the2fye/16v-boost-converter/hardware/boost_converter.kicad_pcb

## KiCad design hardware/boost_converter.kicad_pcb (2026-11-09)

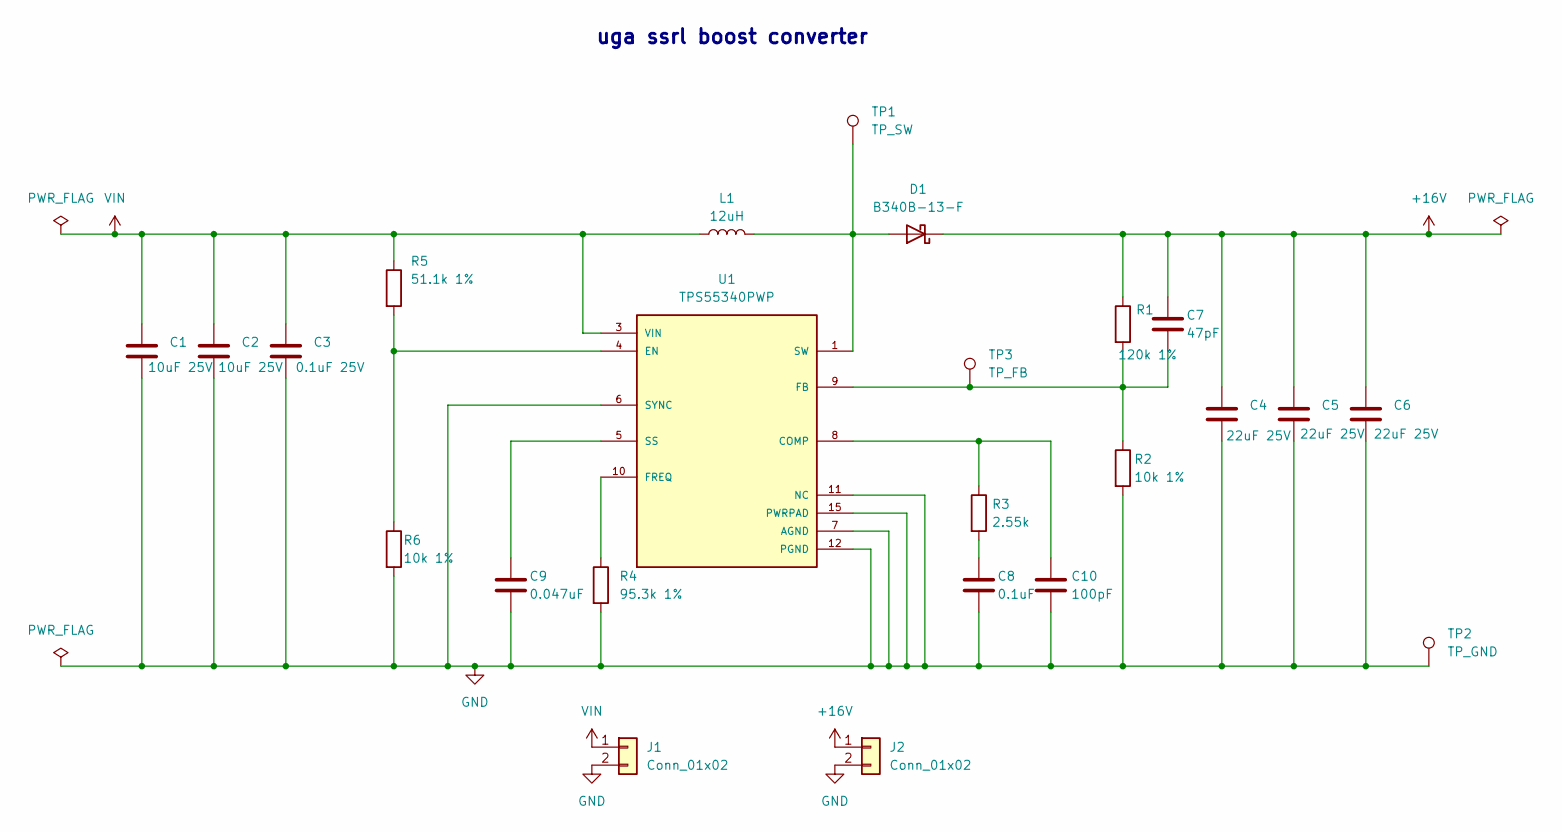
[picture p5: schematic boost_converter.kicad_sch]

Parts:
C1, C2: 10uF 25V; C_0805_2012Metric; MPN Murata GRM21BR61E106KA73L
C3: 0.1uF 25V; C_0603_1608Metric; MPN Murata GRM188R71E104KA01D
C4, C5, C6: 22uF 25V; C_1210_3225Metric; MPN Murata GRM32ER71E226KE15L
C7: 47pF; C_0603_1608Metric; MPN Murata GRM1885C1H470JA01D
C8: 0.1uF; C_0603_1608Metric; MPN Murata GRM188R71H104KA93D
C9: 0.047uF; C_0603_1608Metric; MPN Murata GRM188R71H473KA61D
C10: 100pF; C_0603_1608Metric; MPN Murata GRM1885C1H101JA01D
D1: B340B-13-F; D_SMB; MPN Diodes Inc. B340B-13-F
J1, J2: Conn_01x02; PinHeader_1x02_P2.54mm_Vertical; MPN Würth 61300211121
L1: 12uH; 744393465120; MPN Würth 744393465120
R1: 120k 1%; R_0603_1608Metric; MPN Yageo RC0603FR-07120KL
R2, R6: 10k 1%; R_0603_1608Metric; MPN Yageo RC0603FR-0710KL
R3: 2.55k; R_0603_1608Metric; MPN Yageo RC0603FR-072K55L
R4: 95.3k 1%; R_0603_1608Metric; MPN Yageo RC0603FR-0795K3L
R5: 51.1k 1%; R_0603_1608Metric; MPN Yageo RC0603FR-0751K1L
TP1: TP_SW; TestPoint_Pad_1.5x1.5mm
TP2: TP_GND; TestPoint_Pad_1.5x1.5mm
TP3: TP_FB; TestPoint_Pad_1.5x1.5mm
U1: TPS55340PWP; IC_TPS55340PWP; PARTREV E

Connections:
+16V: C4.1, C5.1, C6.1, C7.1, D1.1 (K), J2.1, R1.1
GND: C1.2, C2.2, C3.2, C4.2, C5.2, C6.2, C8.2, C9.2, C10.2, J1.2, J2.2, R2.2, R4.2, R6.2, TP2.1, U1.6 (SYNC), U1.7 (AGND), U1.11 (NC), U1.12 (PGND), U1.13 (PGND), U1.14 (PGND), U1.15 (PWRPAD), U1.16 (PWRPAD), U1.17 (PWRPAD), U1.18 (PWRPAD), U1.19 (PWRPAD), U1.20 (PWRPAD), U1.21 (PWRPAD)
unnamed: C8.1, R3.2
unnamed: D1.2 (A), L1.2, TP1.1, U1.1 (SW), U1.2 (SW)
unnamed: C10.1, R3.1, U1.8 (COMP)
unnamed: R5.2, R6.1, U1.4 (EN)
unnamed: C7.2, R1.2, R2.1, TP3.1, U1.9 (FB)
unnamed: R4.1, U1.10 (FREQ)
unnamed: C9.1, U1.5 (SS)
VIN: C1.1, C2.1, C3.1, J1.1, L1.1, R5.1, U1.3 (VIN)

Notes on the sheet:
uga ssrl boost converter

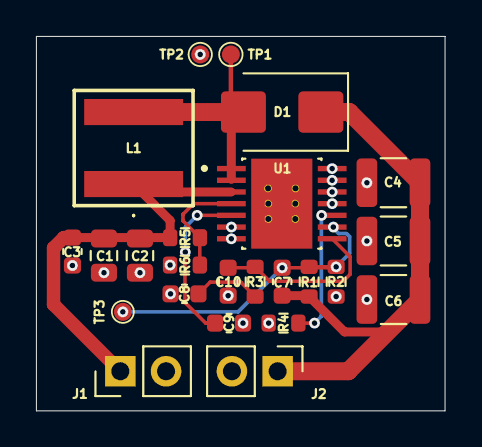
[picture p6: board boost_converter.kicad_pcb from above]

Board: 2 copper layers, 22.7 x 20.8 mm, 24 parts (0 on the bottom side), 10 nets.
