the2fye/16v-boost-converter/(commit log)

2026-11-09 Add KiCad project and schematic
    TPS55340 boost stage, 120k/10k feedback divider for 16 V,
    51.1k/10k EN divider for ~6.6 V battery UVLO, 500 kHz FREQ resistor.
    [boost_converter.kicad_sch]
2026-11-09 Add 2-layer PCB layout
    22.7 x 20.8 mm board, tight SW-D1-Cout loop, solid bottom ground
    pour, six thermal vias under the PowerPAD, DRC clean.
    [boost_converter.kicad_pcb]
2026-11-09 Add gerbers and BOM
    BOM lists C1/C2 as X5R to match the Murata GRM21BR61E106 part.
    [boost_converter_BOM.csv]
2026-11-09 Add design report and board images
